JackSimplicio/bancada-diagnostico-bldc/ensaios/README.md

# Ensaios

| Arquivo | Conteúdo |
|---|---|
| `testes_iniciais_2fios_x_kelvin.csv` | Evolução das montagens a 2 fios até a medição Kelvin (motor sadio) |
| `2026-11-09_diagnostico_estatico_kelvin.csv` | Diagnóstico estático Kelvin: motor sadio e curto simulado U–V |
| `2026-11-09_prints_diagnostico_estatico.png` | Página web da bancada nos dois ensaios (APROVADO / REPROVADO) |

**Condições:** motor KTC42BLS04-J desconectado do driver, temperatura ambiente, sem correção de temperatura.
Os ensaios de 09/11/2026 foram feitos com limite de desequilíbrio configurado em 6 %; o padrão do firmware é 5 % (resultados inalterados).

**Pendente:** ensaio sob carga (configuração B), não realizado nesta etapa por problema no módulo INA226; repetibilidade do diagnóstico estático; fase aberta e fase degradada simuladas.
