JackSimplicio/bancada-diagnostico-bldc/docs/fluxograma_firmware.png

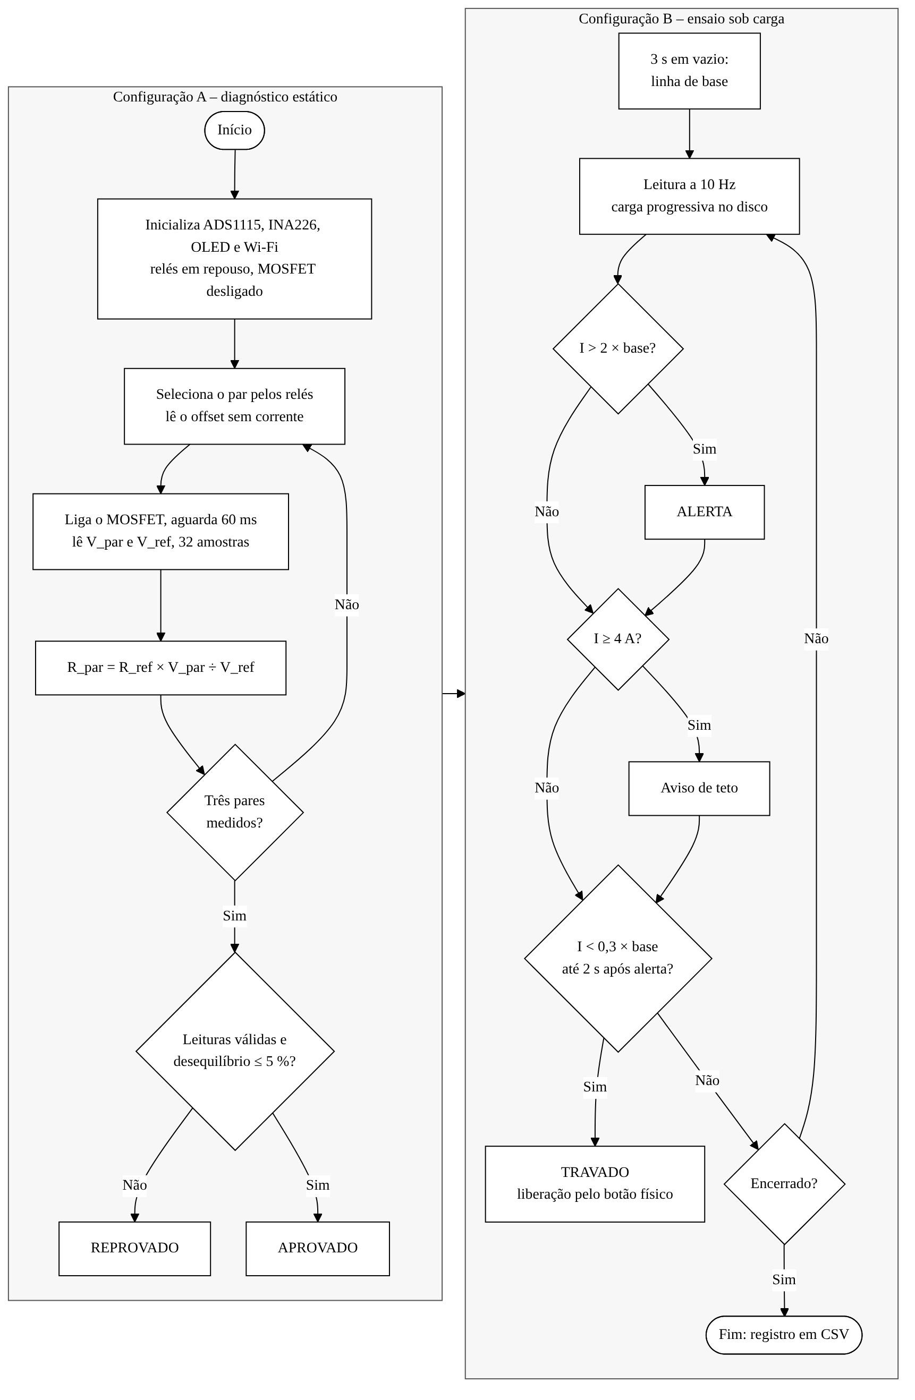
docs/fluxograma_firmware.png
