JackSimplicio/bancada-diagnostico-bldc/hardware/diagrama_funcional/diagrama_funcional_detalhado.png

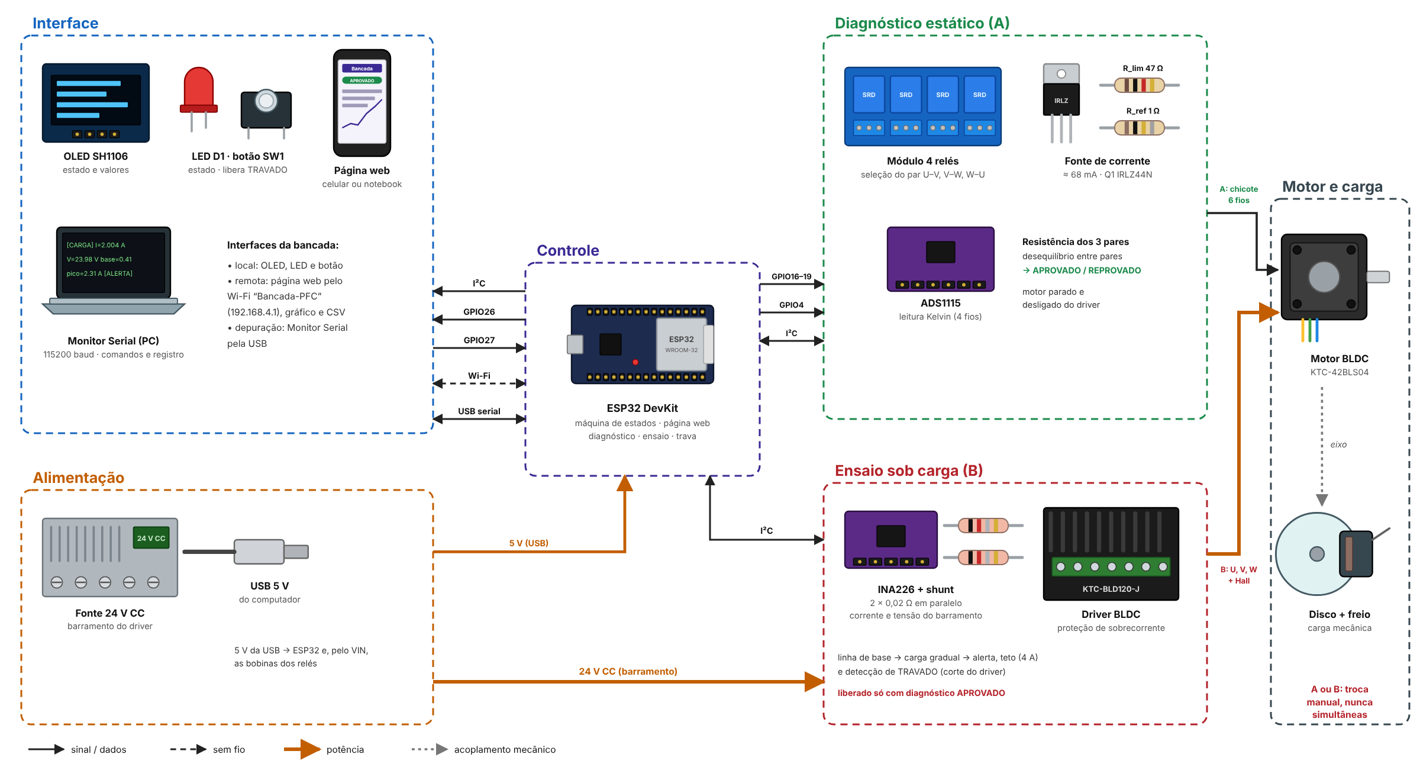
hardware/diagrama_funcional/diagrama_funcional_detalhado.png
