JackSimplicio/bancada-diagnostico-bldc/hardware/esquemas/folha1_visao_geral.png

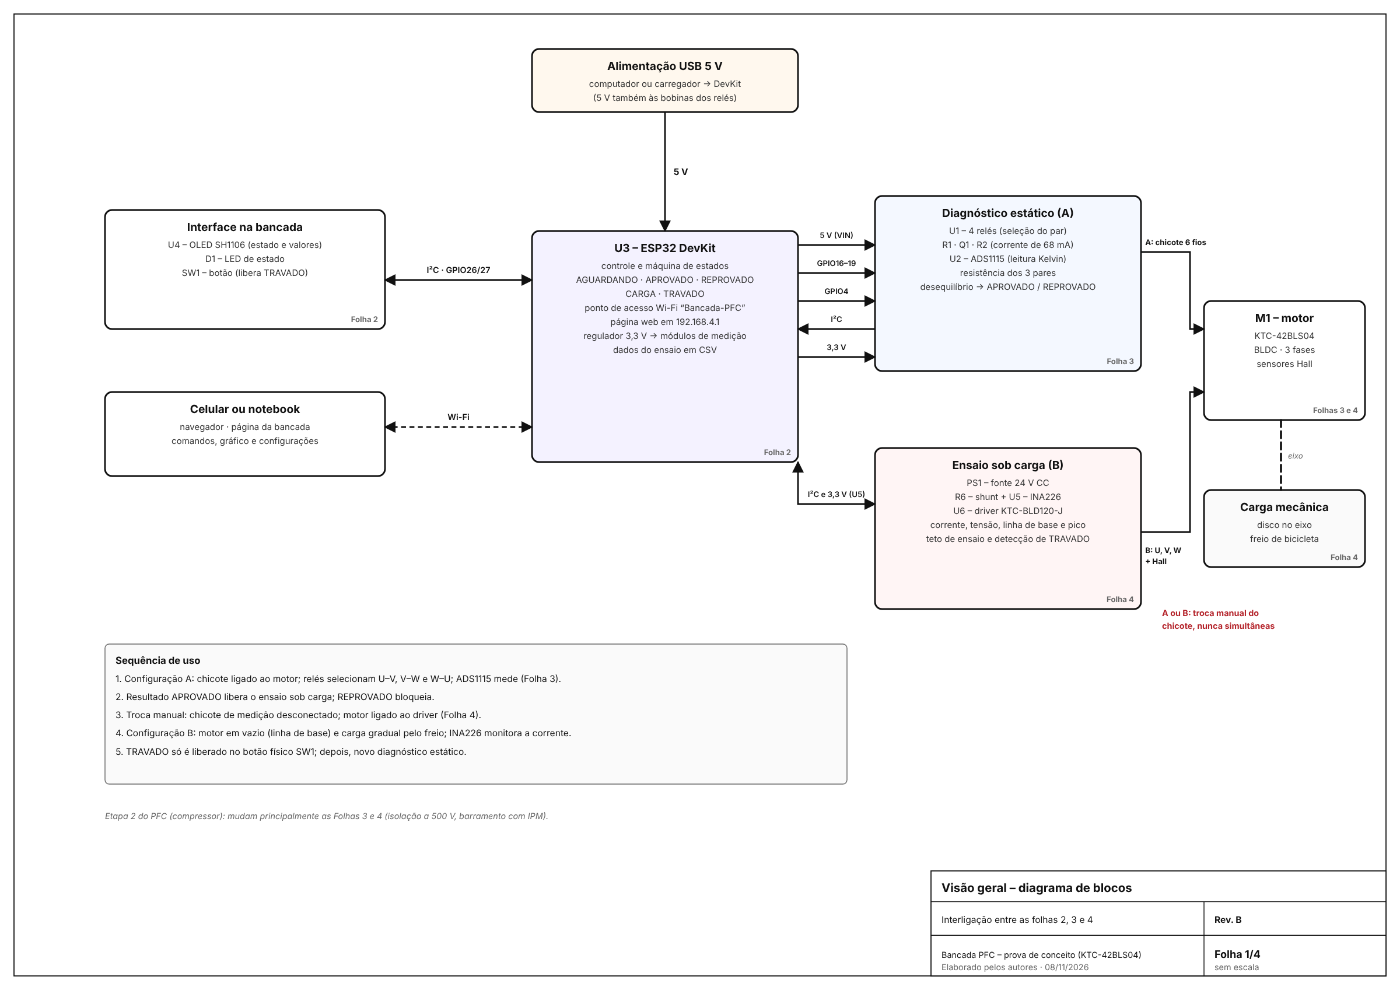
hardware/esquemas/folha1_visao_geral.png
