JackSimplicio/bancada-diagnostico-bldc/ensaios/2026-11-09_prints_diagnostico_estatico.png

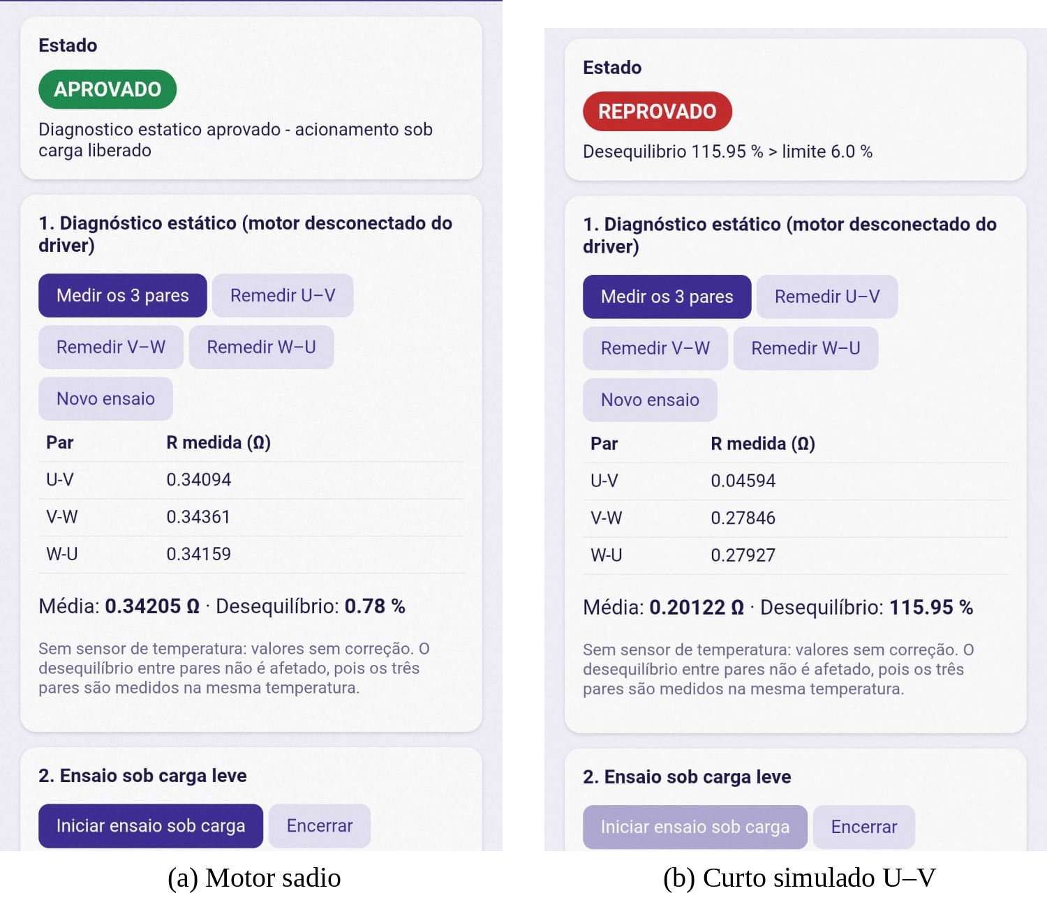
ensaios/2026-11-09_prints_diagnostico_estatico.png
